ParityParty/FpgaFlashTester/flash_programmer/flash_programmer.ip_user_files/README.txt

The files in this directory structure are automatically generated and managed by Vivado. Editing these files is not recommended.
