ParityParty/FpgaFlashTester/flash_programmer/flash_programmer.gen/sources_1/bd/design_1/ip/design_1_nand_controller_0_0/synth/design_1_nand_controller_0_0.vhd

-- (c) Copyright 1986-2022 Xilinx, Inc. All Rights Reserved.
-- (c) Copyright 2022-2025 Advanced Micro Devices, Inc. All rights reserved.
-- 
-- This file contains confidential and proprietary information
-- of AMD and is protected under U.S. and international copyright
-- and other intellectual property laws.
-- 
-- DISCLAIMER
-- This disclaimer is not a license and does not grant any
-- rights to the materials distributed herewith. Except as
-- otherwise provided in a valid license issued to you by
-- AMD, and to the maximum extent permitted by applicable
-- law: (1) THESE MATERIALS ARE MADE AVAILABLE "AS IS" AND
-- WITH ALL FAULTS, AND AMD HEREBY DISCLAIMS ALL WARRANTIES
-- AND CONDITIONS, EXPRESS, IMPLIED, OR STATUTORY, INCLUDING
-- BUT NOT LIMITED TO WARRANTIES OF MERCHANTABILITY, NON-
-- INFRINGEMENT, OR FITNESS FOR ANY PARTICULAR PURPOSE; and
-- (2) AMD shall not be liable (whether in contract or tort,
-- including negligence, or under any other theory of
-- liability) for any loss or damage of any kind or nature
-- related to, arising under or in connection with these
-- materials, including for any direct, or any indirect,
-- special, incidental, or consequential loss or damage
-- (including loss of data, profits, goodwill, or any type of
-- loss or damage suffered as a result of any action brought
-- by a third party) even if such damage or loss was
-- reasonably foreseeable or AMD had been advised of the
-- possibility of the same.
-- 
-- CRITICAL APPLICATIONS
-- AMD products are not designed or intended to be fail-
-- safe, or for use in any application requiring fail-safe
-- performance, such as life-support or safety devices or
-- systems, Class III medical devices, nuclear facilities,
-- applications related to the deployment of airbags, or any
-- other applications that could lead to death, personal
-- injury, or severe property or environmental damage
-- (individually and collectively, "Critical
-- Applications"). Customer assumes the sole risk and
-- liability of any use of AMD products in Critical
-- Applications, subject only to applicable laws and
-- regulations governing limitations on product liability.
-- 
-- THIS COPYRIGHT NOTICE AND DISCLAIMER MUST BE RETAINED AS
-- PART OF THIS FILE AT ALL TIMES.
-- 
-- DO NOT MODIFY THIS FILE.

-- IP VLNV: xilinx.com:module_ref:nand_controller:1.0
-- IP Revision: 1

LIBRARY ieee;
USE ieee.std_logic_1164.ALL;
USE ieee.numeric_std.ALL;

ENTITY design_1_nand_controller_0_0 IS
  PORT (
    i_clk : IN STD_LOGIC;
    i_rst : IN STD_LOGIC;
    i_activate : IN STD_LOGIC;
    i_cmd : IN STD_LOGIC_VECTOR(7 DOWNTO 0);
    i_address : IN STD_LOGIC_VECTOR(39 DOWNTO 0);
    i_data : IN STD_LOGIC_VECTOR(7 DOWNTO 0);
    o_data : OUT STD_LOGIC_VECTOR(7 DOWNTO 0);
    o_busy : OUT STD_LOGIC;
    o_read_done : OUT STD_LOGIC;
    i_nand_rb : IN STD_LOGIC;
    o_nand_we : OUT STD_LOGIC;
    o_nand_wp : OUT STD_LOGIC;
    o_nand_cle : OUT STD_LOGIC;
    o_nand_ale : OUT STD_LOGIC;
    o_nand_re : OUT STD_LOGIC;
    io_nand_data : INOUT STD_LOGIC_VECTOR(7 DOWNTO 0);
    o_nand_ce : OUT STD_LOGIC
  );
END design_1_nand_controller_0_0;

ARCHITECTURE design_1_nand_controller_0_0_arch OF design_1_nand_controller_0_0 IS
  ATTRIBUTE DowngradeIPIdentifiedWarnings : STRING;
  ATTRIBUTE DowngradeIPIdentifiedWarnings OF design_1_nand_controller_0_0_arch: ARCHITECTURE IS "yes";
  COMPONENT nand_controller IS
    GENERIC (
      PAGE_SIZE : INTEGER
    );
    PORT (
      i_clk : IN STD_LOGIC;
      i_rst : IN STD_LOGIC;
      i_activate : IN STD_LOGIC;
      i_cmd : IN STD_LOGIC_VECTOR(7 DOWNTO 0);
      i_address : IN STD_LOGIC_VECTOR(39 DOWNTO 0);
      i_data : IN STD_LOGIC_VECTOR(7 DOWNTO 0);
      o_data : OUT STD_LOGIC_VECTOR(7 DOWNTO 0);
      o_busy : OUT STD_LOGIC;
      o_read_done : OUT STD_LOGIC;
      i_nand_rb : IN STD_LOGIC;
      o_nand_we : OUT STD_LOGIC;
      o_nand_wp : OUT STD_LOGIC;
      o_nand_cle : OUT STD_LOGIC;
      o_nand_ale : OUT STD_LOGIC;
      o_nand_re : OUT STD_LOGIC;
      io_nand_data : INOUT STD_LOGIC_VECTOR(7 DOWNTO 0);
      o_nand_ce : OUT STD_LOGIC
    );
  END COMPONENT nand_controller;
  ATTRIBUTE X_CORE_INFO : STRING;
  ATTRIBUTE X_CORE_INFO OF design_1_nand_controller_0_0_arch: ARCHITECTURE IS "nand_controller,Vivado 2025.1";
  ATTRIBUTE CHECK_LICENSE_TYPE : STRING;
  ATTRIBUTE CHECK_LICENSE_TYPE OF design_1_nand_controller_0_0_arch : ARCHITECTURE IS "design_1_nand_controller_0_0,nand_controller,{}";
  ATTRIBUTE CORE_GENERATION_INFO : STRING;
  ATTRIBUTE CORE_GENERATION_INFO OF design_1_nand_controller_0_0_arch: ARCHITECTURE IS "design_1_nand_controller_0_0,nand_controller,{x_ipProduct=Vivado 2025.1,x_ipVendor=xilinx.com,x_ipLibrary=module_ref,x_ipName=nand_controller,x_ipVersion=1.0,x_ipCoreRevision=1,x_ipLanguage=VHDL,x_ipSimLanguage=MIXED,PAGE_SIZE=8640}";
  ATTRIBUTE IP_DEFINITION_SOURCE : STRING;
  ATTRIBUTE IP_DEFINITION_SOURCE OF design_1_nand_controller_0_0_arch: ARCHITECTURE IS "module_ref";
  ATTRIBUTE X_INTERFACE_INFO : STRING;
  ATTRIBUTE X_INTERFACE_MODE : STRING;
  ATTRIBUTE X_INTERFACE_PARAMETER : STRING;
  ATTRIBUTE X_INTERFACE_INFO OF i_clk: SIGNAL IS "xilinx.com:signal:clock:1.0 i_clk CLK";
  ATTRIBUTE X_INTERFACE_MODE OF i_clk: SIGNAL IS "slave i_clk";
  ATTRIBUTE X_INTERFACE_PARAMETER OF i_clk: SIGNAL IS "XIL_INTERFACENAME i_clk, ASSOCIATED_RESET i_rst, FREQ_HZ 100000000, FREQ_TOLERANCE_HZ 0, PHASE 0.0, CLK_DOMAIN design_1_clk_wiz_0_0_clk_out1, INSERT_VIP 0";
  ATTRIBUTE X_INTERFACE_INFO OF i_rst: SIGNAL IS "xilinx.com:signal:reset:1.0 i_rst RST";
  ATTRIBUTE X_INTERFACE_MODE OF i_rst: SIGNAL IS "slave i_rst";
  ATTRIBUTE X_INTERFACE_PARAMETER OF i_rst: SIGNAL IS "XIL_INTERFACENAME i_rst, POLARITY ACTIVE_LOW, INSERT_VIP 0";
BEGIN
  U0 : nand_controller
    GENERIC MAP (
      PAGE_SIZE => 8640
    )
    PORT MAP (
      i_clk => i_clk,
      i_rst => i_rst,
      i_activate => i_activate,
      i_cmd => i_cmd,
      i_address => i_address,
      i_data => i_data,
      o_data => o_data,
      o_busy => o_busy,
      o_read_done => o_read_done,
      i_nand_rb => i_nand_rb,
      o_nand_we => o_nand_we,
      o_nand_wp => o_nand_wp,
      o_nand_cle => o_nand_cle,
      o_nand_ale => o_nand_ale,
      o_nand_re => o_nand_re,
      io_nand_data => io_nand_data,
      o_nand_ce => o_nand_ce
    );
END design_1_nand_controller_0_0_arch;
