ParityParty/FpgaFlashTester/flash_programmer/flash_programmer.gen/sources_1/bd/design_1/ip/design_1_clk_wiz_0_0/design_1_clk_wiz_0_0_stub.v

// Copyright 1986-2022 Xilinx, Inc. All Rights Reserved.
// Copyright 2022-2025 Advanced Micro Devices, Inc. All Rights Reserved.
// --------------------------------------------------------------------------------
// Tool Version: Vivado v.2025.1 (lin64) Build 6140274 Wed May 21 22:58:25 MDT 2025
// Date        : Thu Sep 11 10:54:53 2025
// Host        : agata running 64-bit Ubuntu 24.04.3 LTS
// Command     : write_verilog -force -mode synth_stub
//               /home/agata/FpgaFlashTester/flash_programmer/flash_programmer.gen/sources_1/bd/design_1/ip/design_1_clk_wiz_0_0/design_1_clk_wiz_0_0_stub.v
// Design      : design_1_clk_wiz_0_0
// Purpose     : Stub declaration of top-level module interface
// Device      : xck26-sfvc784-2LV-c
// --------------------------------------------------------------------------------

// This empty module with port declaration file causes synthesis tools to infer a black box for IP.
// The synthesis directives are for Synopsys Synplify support to prevent IO buffer insertion.
// Please paste the declaration into a Verilog source file or add the file as an additional source.
(* CORE_GENERATION_INFO = "design_1_clk_wiz_0_0,clk_wiz_v6_0_16_0_0,{component_name=design_1_clk_wiz_0_0,use_phase_alignment=false,use_min_o_jitter=false,use_max_i_jitter=false,use_dyn_phase_shift=false,use_inclk_switchover=false,use_dyn_reconfig=false,enable_axi=0,feedback_source=FDBK_AUTO,PRIMITIVE=MMCM,num_out_clk=1,clkin1_period=40.000,clkin2_period=10.0,use_power_down=false,use_reset=true,use_locked=true,use_inclk_stopped=false,feedback_type=SINGLE,CLOCK_MGR_TYPE=NA,manual_override=false}" *) 
module design_1_clk_wiz_0_0(clk_out, reset, locked, clk_in1)
/* synthesis syn_black_box black_box_pad_pin="reset,locked,clk_in1" */
/* synthesis syn_force_seq_prim="clk_out" */;
  output clk_out /* synthesis syn_isclock = 1 */;
  input reset;
  output locked;
  input clk_in1;
endmodule
