ParityParty/FpgaFlashTester/(commit log)

2025-09-04 Add UART
2025-09-08 Read device ID
2025-09-26 add reset and status
    [nand_controller.vhd, tb_nand_controller.vhd]
2025-09-30 known bad block avoidance
    [design_1.v, flash_programmer.vhd]
2025-10-01 speed up uart
2025-10-02 wip cables cut
2025-10-02 Make uart send multiple bytes
2025-10-10 speed up uart even more
2025-10-10 speed up clock to 100mhz, slow down uart to +-400mbd
2025-10-10 debug uart
2025-10-10 wip upgrade error reporting
    [design_1.vhd, design_1_wrapper.vhd, flash_programmer.vhd]
2025-10-13 add uart monitors
2025-10-27 Plot dose v errors
    [read_analyser.py]
